aks3g/ai_mini_4wd_kit/src/README.md

# AI ミニ四駆キットSDK
AIミニ四駆キット向けのソフトウェアの開発を行うためのSDKです

## SDK構成
SDKはライブラリ（.aファイルと.hファイル）で提供されます。library/libに.aファイルが、library/includeに.hが入っています。
ライブラリを生成するのに必要なコードはすべて含まれています。

## micro python
本SDKにはmicro pythonのポーティングコードが含まれています。バージョン1.9.4に対するポーティングコードなので、それ以外のバージョンでの動作確認は行っていません。

### 使用方法
メモリカードにBOOT.INIというファイル名の設定ファイルを作成します。
ファイルの中身を次のように記載してください。

```
BOOT.INI
script=<実行したいスクリプトファイル名>
```

このファイルが置かれたメモリカードを挿入して電源をONにすると、指定したスクリプトファイルの実行がスタートします。
