aks3g/ai_mini_4wd_kit/src/release/README.md

ファームウェアのリリース場所です。

### 2019/09/22
初期リリースです。
Bootloaderを新たに用意しました。
microPythonの実効環境を用意しました。
