aks3g/ai_mini_4wd_kit/src/scripts/README.md

# micro Python用サンプルスクリプト集
AIミニ四駆Kit用micro Pythonのサンプルコードです。ほかのPython処理系では動かないのでご注意ください。
また、サンプルコードにBOMがついているとうまく読めない為、BOM無しでメモリカードに保存するようにしてください。

## 注意事項
***古いファームウェアでは、ファイルシステムがロングファイルネームに対応しておりません（いわゆる8文字＋拡張子3文字の名前しか使えない）***
サンプルのご使用に当たってはファイルのリネームをしていただければともいます。
micro Pythonポーティングをビルドして書き込める環境であれば、現在公開されているモノであればログファイルネームが使えます。

***古いファームウェアにはバグが存在し、メモリカード上にtest.pyが存在している必要があります。中身は空でも構いません***

## 使用方法
サンプルスクリプトを使用するための方法を説明します。
### 準備
1. AIミニ四駆Kitとメモリカード（MMC互換カード）を用意します
2. AIミニ四駆Kitにmicro Pythonが動くファームウェアが書き込まれている事を確認します（出荷状態で書き込み済みです）

### 実行手順
1. メモリカードにBOOT.INIというファイルを用意します
BOOT.INIの中に次のような行を記載します。スクリプトファイルの名前は適宜変更してください。
```script = 00x_sample_name_to_execute.py```

2. BOOT.INIで指定したスクリプトをメモリカードに書き込みます
3. メモリカードをAIミニ四駆Kitに差し込みます
4. 電源をONにすると、BOOT.INIにで指定されたスクリプトが実行されます

## サンプル一覧
公開されている（或いは公開予定の）サンプルスクリプトの一覧です

|サンプル名|概要|
|:--------|:---|
|001_sample_LED.py|LEDを点灯させるサンプル|
|002_sample_Switch.py|スイッチ操作を行うサンプル|
|003_sample_move.py|モータードライバを操作するサンプル|
|004_sample_control_velocity.py|PID制御によって、速度を一定に保って走行するサンプル|
|005_sample_internal_trigger.py|内部トリガー（車軸の回転検知）を利用するサンプル|
|006_sample_logging.py|センサのデータを取得しながら走行し、その値をログに残すサンプル|
