aks3g/ai_mini_4wd_kit/doc/notes.pdf

## AI ミニ四駆キット 注意事項

ご使用に当たっての注意事項

AI ミニ四駆キットのソフトウェアは開発が継続中です。ソフトウェアの書き込みには JTAG書き込み機（J-Link や Atmel-Ice など）が別途必要になります。

MMC 互換カードをサポートしていますが、すべてのカードをサポート出来ているわけではありません。場合によっ ては使用できない、あるいはファイルシステムが壊れてファイルが読めなくなるなどの事故が起こる可能性がありま す。内容が消えても問題がない状態のカードをご使用ください。

ハードウェアの不具合について

初期不良については、交換対応をさせていただきます。返金も受け付けますが、バッテリの接続端子は消耗品 であるため、接続端子の家格分を差し引いた金額の返金となる事をご了承ください。 故障時の修理対応も行いますが、製品の性質上（ミニ四駆に載せて走らせてコースアウトすることも多い）、 お受けできない場合もございます。

困ったときは

ハードウェア的な問題か、ソフト的な問題か判別できない場合、Github の Issue にて問題を指摘していただ ければ対応いたします。

Github:https://github.com/aks3g/ai_mini_4wd_kit

問い合わせ先
ハードウェア不具合など、お問い合わせは以下のいずれかにお願いします。 e-mail: Kiyotaka.aks@gmail.com
twitter : https://twitter.com/g_aks

サークル名:あかまる
