aks3g/ai_mini_4wd_kit/doc/figure/connect3.png

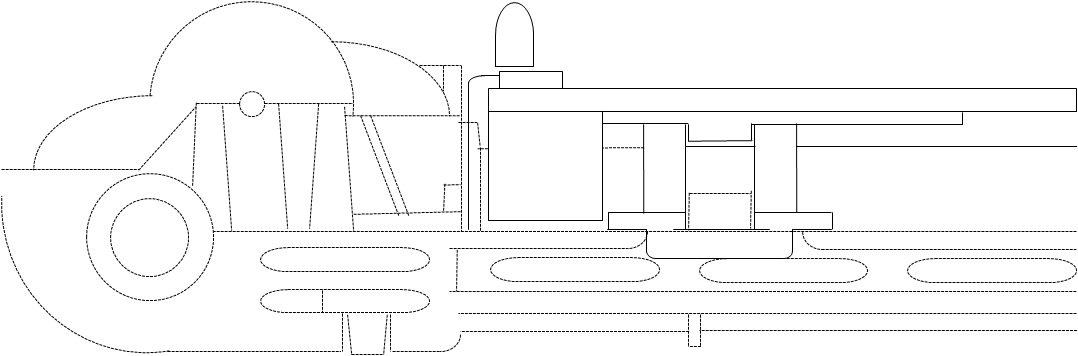
doc/figure/connect3.png
