aks3g/ai_mini_4wd_kit/(threads)

Thread 1 (2019-05-11):

test.pyを配置しないとBOOT.INIが読み込まれない

yukota, 2019-05-11:
test.pyを配置しなかった場合、fatal_errorになり、結果としてBOOT.INIが読み込まれません。
src/script以下にtest.pyを置くか、test.pyがない場合fatalに落ちないようにしたほうがわかりやすいかと思います。

aks3g, 2019-05-13:
期待通りの動きではない（BOOT.INIがtest.pyに依存するのはおかしい）ので修正します。

aks3g, 2019-05-13:
こちら、すいませんコミット前に確認したはずがデバッグ中のコードが残っておりました。
https://github.com/aks3g/ai_mini_4wd_kit/commit/45d6fbbb8115bdc94f4985d53593735f37e6d077

こちらで修正済みです（お恥ずかしい）

yukota, 2019-05-13:
Thank you!

Closed 2019-05-13.

Thread 2 (2019-05-11):

fatal_error時にログが0で埋められる

yukota, 2019-05-11:
__fatal_error時にすべて0で埋められた1MBほどのLOGが出力されれます。
test.pyを配置せず起動した時発生しました。

aks3g, 2019-05-13:
すいません。こちらエラー時の処理の実装がおかしいですね。
1MBの0埋めファイルが出力されるのは期待通りで、一旦フラッシュ上に1MBのファイルを生成しておくことで、フラッシュへの書き込み速度を向上することを狙っています。
通常処理では、スクリプト実行が終わった時点でファイルサイズを切り詰めているのですが、fatal_errorでのハンドリングに失敗しています。こちら修正いたします。

aks3g, 2019-05-13:
こちらの問題、
https://github.com/aks3g/ai_mini_4wd_kit/commit/397fed656ada02aa9ae12c15ee46a473bcba1de8

で修正しました。Fatalに落ちた後に、FatalメッセージをLOGに書き込んだのちにログファイルのサイズを切り詰める処理を入れたので、Fatalのメッセージも読めるようになります。

yukota, 2019-05-13:
ありがとうございます。

Closed 2019-05-13.

Thread 3 (2019-05-13):

Microchip純正のStartup Codeに依存している

aks3g, 2019-05-13:
Startup CodeがMicrochipの提供しているIncludeファイルに一部依存しているのでWindows環境以外でのビルドが面倒になっている。

単に一部のレジスタの定義を使っているだけのようなので自前で書き直して依存を切りたい気持ち。

aks3g, 2019-09-21:
こちら、Packsフォルダに必要なファイルを取り込むという形で対応しました。

Closed 2019-09-21.

Thread 5 (2019-05-31):

MicroPythonからSDカードに対する書き込みができない

yukota, 2019-05-31:
以下のようなコードを実行すると、writeでAttributeError: no such attributeが発生する。
```python
f = open("out.json", 'w')
f.write("aaaa")
f.close()
```

MicroPythonからSDカード上へのファイルへの出入力手段がほしい。

aks3g, 2019-06-06:
すいません。こちらそもそも対応させてませんでした。
ちょっとお時間もらいますが実装します。しばしお待ちを。

aks3g, 2019-06-11:
下回りのライブラリまで変更を入れたので、library/lib/*.a の類の入れ替えも必要になりますが、
micropython側からSDカードアクセスができるようになりました。

お試しいただければと思います。

yukota, 2019-06-13:
動作しました！
ありがとうございます！

一点だけ、Make内のIncludeですが
/packs/arm/CMSIS/Include
を指定していますが、AtmelStudioから持ってきたpacksは以下のようなディレクトリになっています。
/packs/arm/cmsis/5.0.1/CMSIS/Include
以下のようなシンボリックリンクを貼る必要がある旨をどこかに書いておいたほうが良いかと思います。
ln -s cmsis/5.0.1/CMSIS CMSIS

Closed 2019-06-13.

Thread 8 (2019-06-11):

シャーシの色によってはエンコーダがうまく動いてない（ように思う）

aks3g, 2019-06-11:
光学式エンコーダがシャーシの色に影響を受けているように思うので、対応を考える。

現実的にはコンパレータに設定している閾値（DACで生成）を可変にしてあげる事だろうか…。

aks3g, 2019-09-21:
コンパレータに設定している閾値電圧の変更処理、
閾値電圧のNVMへの保存
セルフキャリブレーション機能の実装を行ったので閉じます。

Closed 2019-09-21.
