aks3g/ai_mini_4wd_kit/elec/schematics_v4.pdf

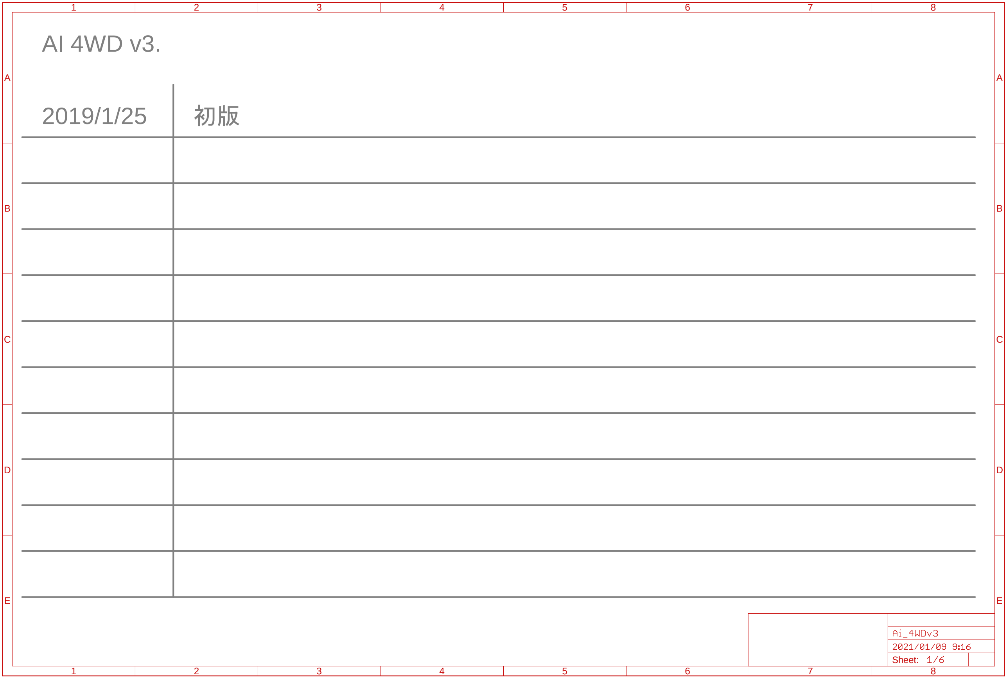
[picture p8: figure]
Sheet:

2021/01/09 9:17 C:\cygwin64\home\kiyot\src\ai_mini_4wd\trunk\elec\circuit\AI_4WDv4\AI_unit\Ai_4WDv3.sch (Sheet: 1/6)

A

A

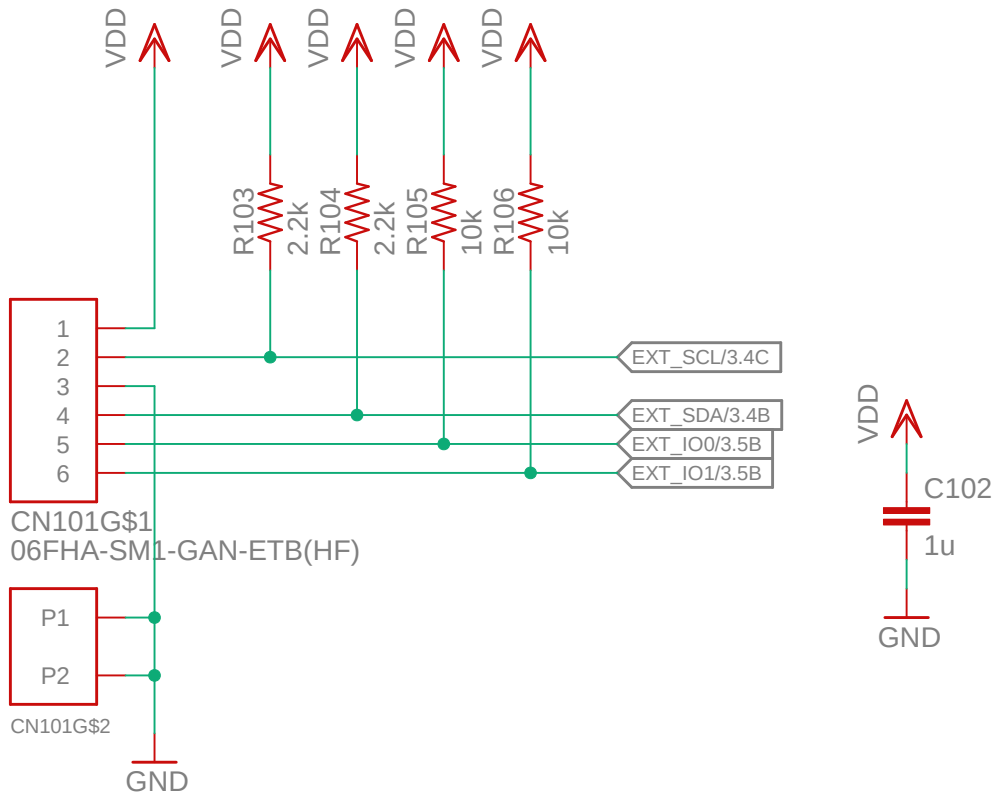
[picture p9: page 2]
GND VDD; 1u VDD; GND ².2k; 10k VDD; VDD; R¹⁰³; R¹⁰⁴; R¹⁰⁵; R¹⁰⁶; EXT_SCL/3.4C; EXT_SDA/3.4B EXT_IO0/3.5B EXT_IO1/3.5B; Sheet:; Ai_4WDv3

06FHA-SM1-GAN-ETB(HF)

2021/01/09 9:17 C:\cygwin64\home\kiyot\src\ai_mini_4wd\trunk\elec\circuit\AI_4WDv4\AI_unit\Ai_4WDv3.sch (Sheet: 2/6)

# GND¹k VDD

GND | GND | 100k | 100k | 100k | 100k | 10k VDD | VDD | VDD | VDD | VDD VDD

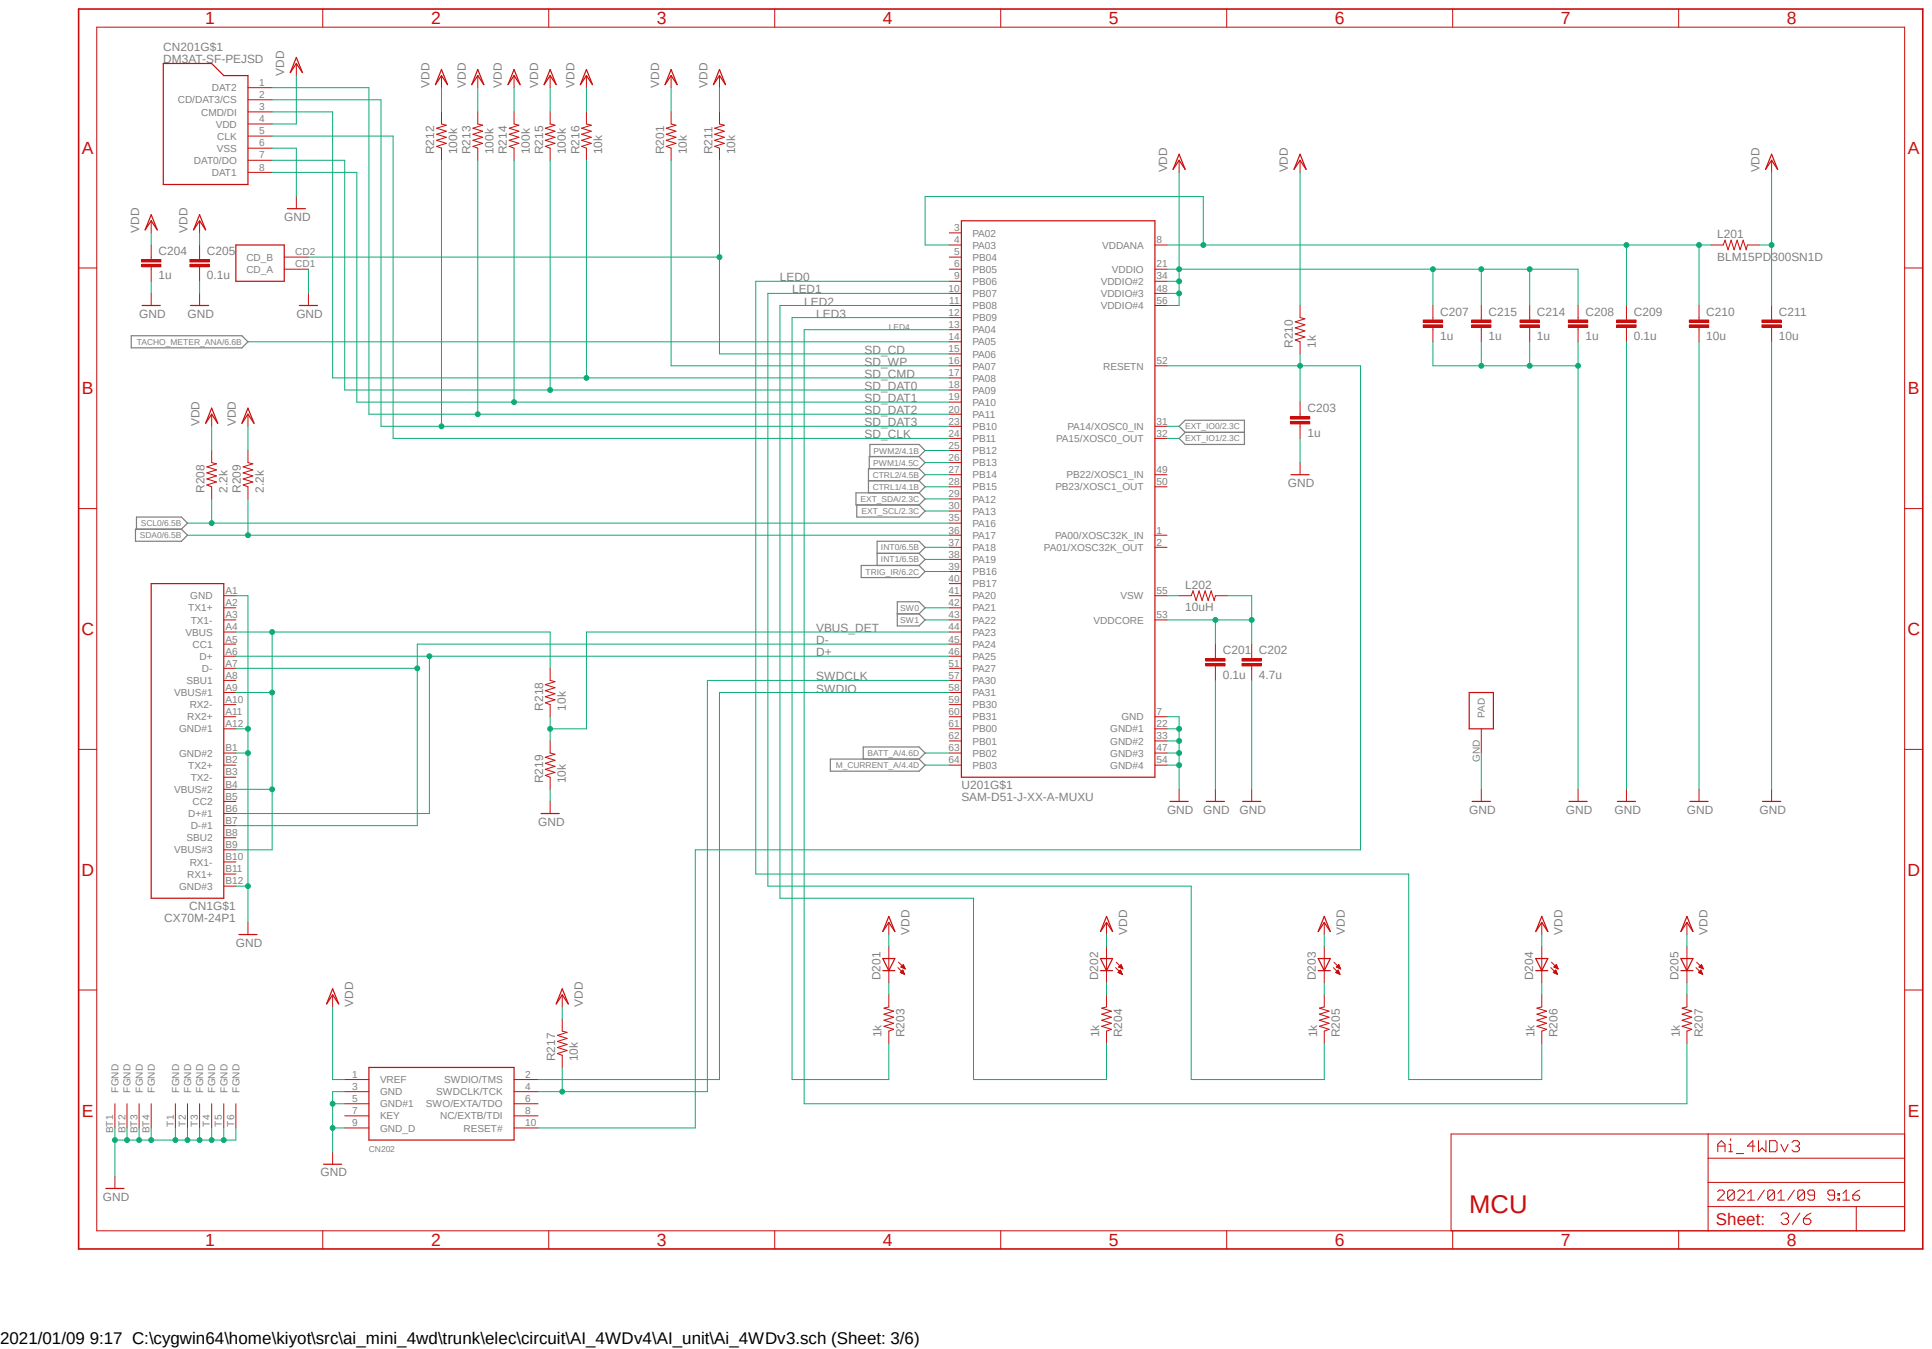
[picture p10: page 3]

SD_CMD | GND VDD L202

LED4 SD_DAT2 SD_CD

SD_WP
SD_DAT0
SD_DAT1
SD_DAT3
SD_CLK

VBUS_DET
D-
D+
SWDCLK
SWDIO

MCU

Sheet:

2021/01/09 9:17 C:\cygwin64\home\kiyot\src\ai_mini_4wd\trunk\elec\circuit\AI_4WDv4\AI_unit\Ai_4WDv3.sch (Sheet: 3/6)

# GND VCC

IN | 3 OUT 4 | GND 2 | U6 VDD | 1

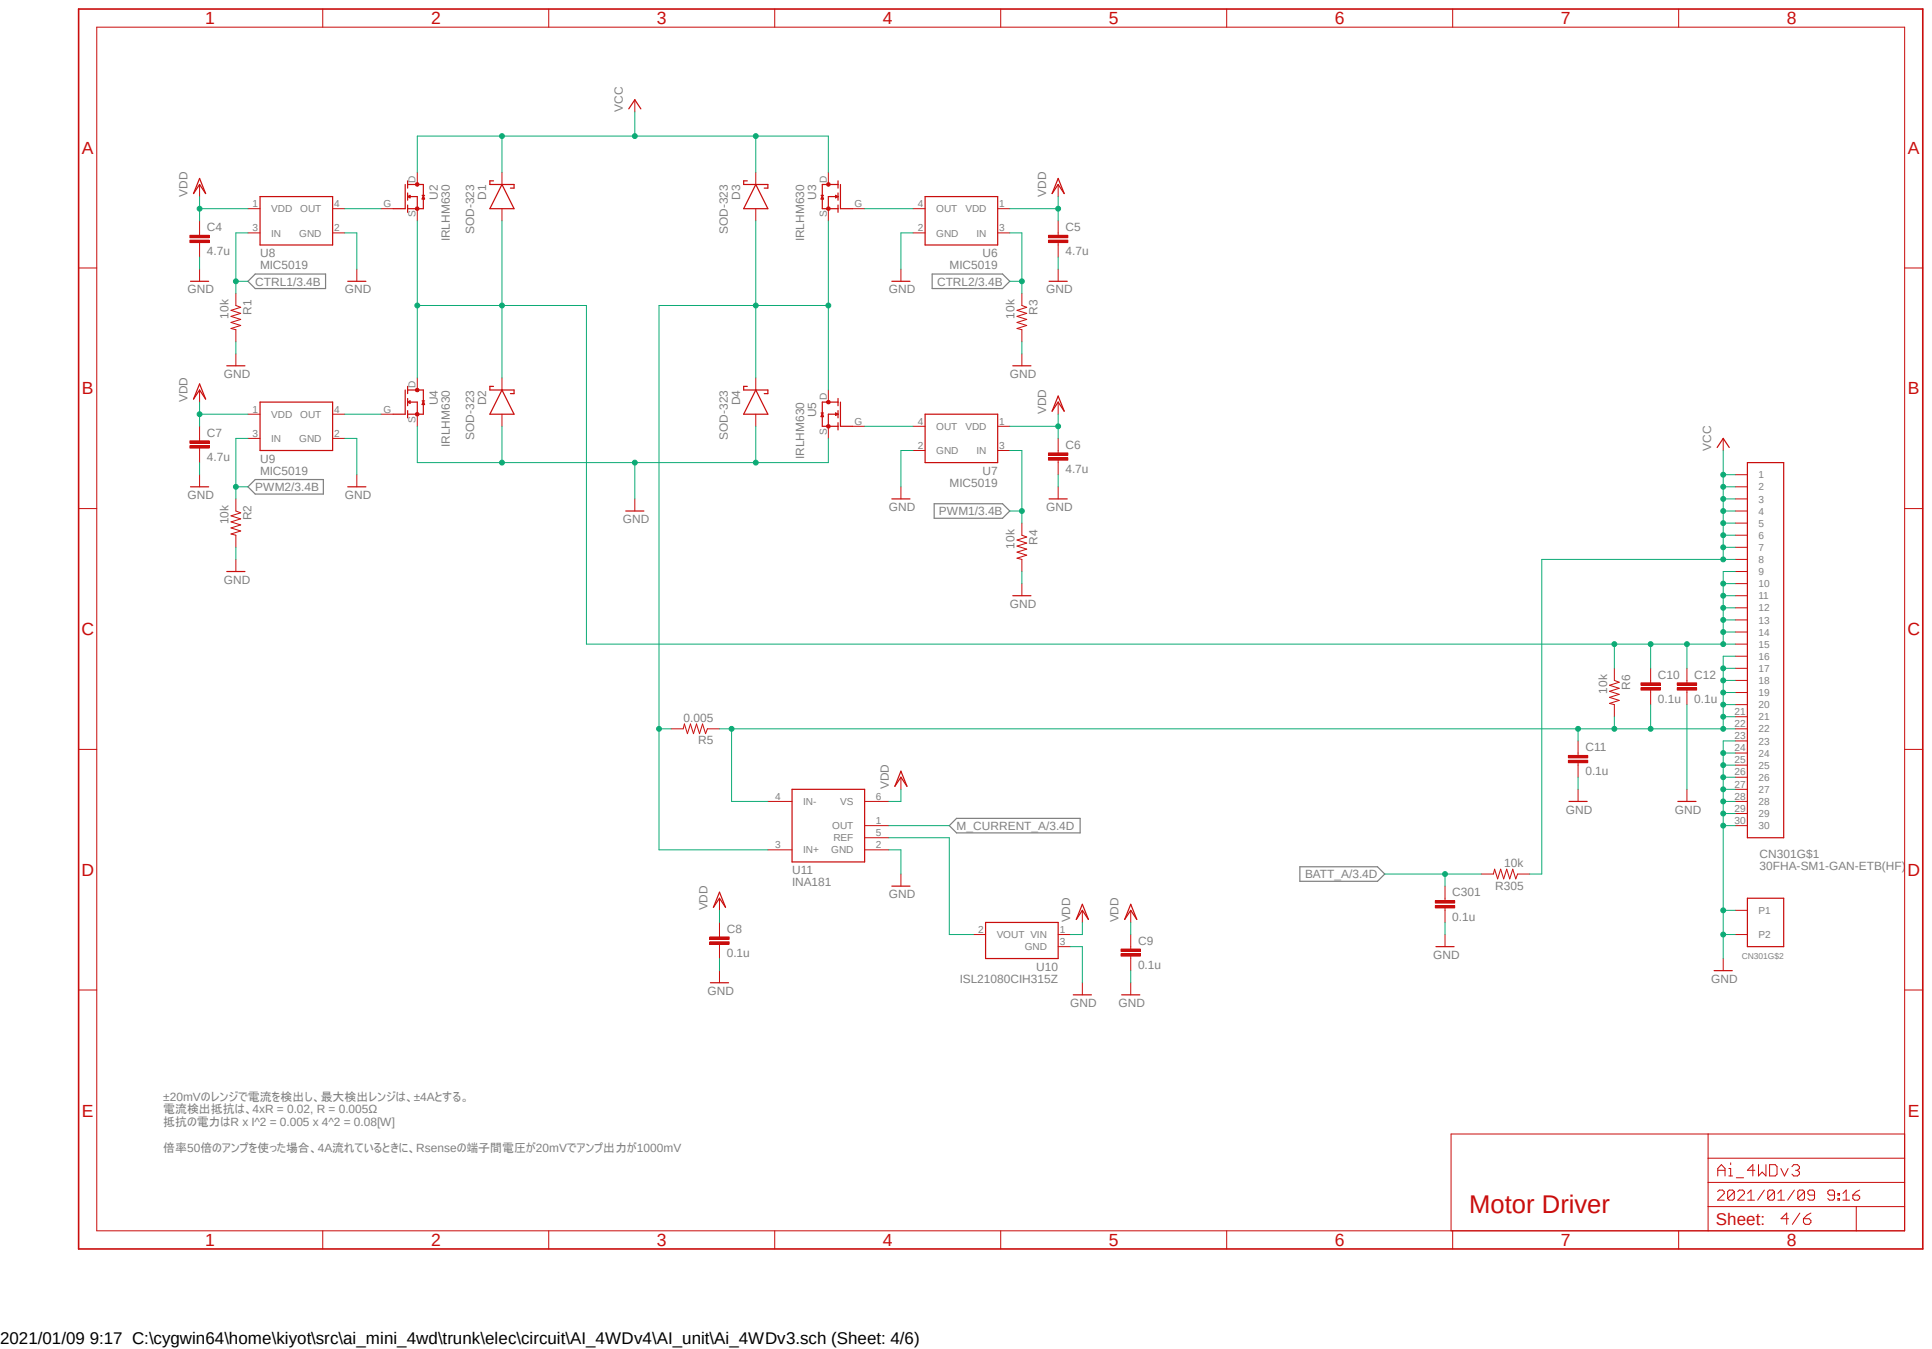
[picture p11: page 4]

2021/01/09 9:17 C:\cygwin64\home\kiyot\src\ai_mini_4wd\trunk\elec\circuit\AI_4WDv4\AI_unit\Ai_4WDv3.sch (Sheet: 4/6)

A

A

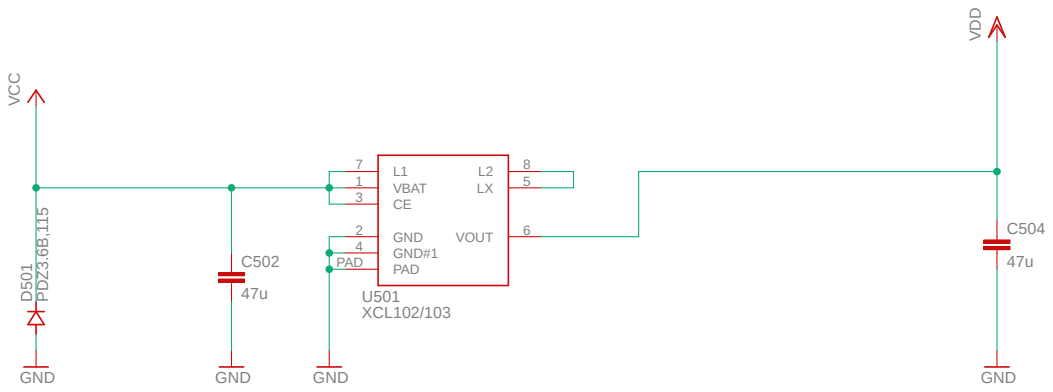
[picture p12: page 5]
GND VCC; VDD; GND; XCL102/103; GND D⁵⁰¹; GND 2; PAD PAD; VOUT; 8 VBAT 1; GND#1 4U501

2021/01/09 9:17 C:\cygwin64\home\kiyot\src\ai_mini_4wd\trunk\elec\circuit\AI_4WDv4\AI_unit\Ai_4WDv3.sch (Sheet: 5/6) PDZ3.6B,115

Power

Sheet:

# GND VDD 51k VDD

A

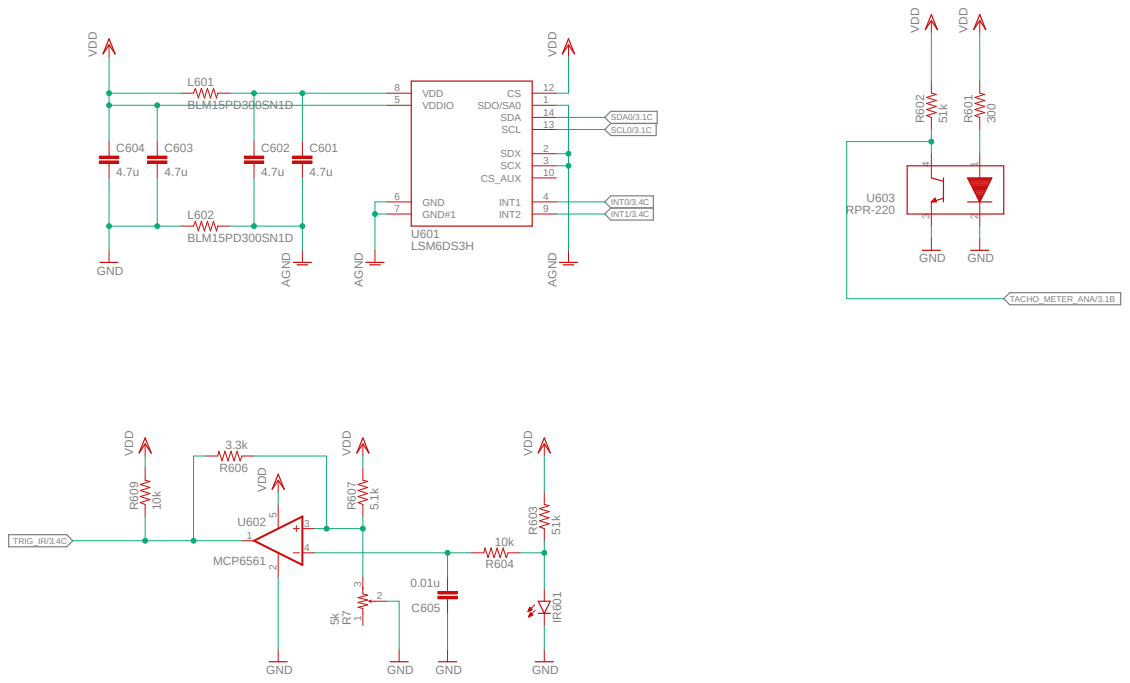
[picture p13: page 6]

Sensor

Sheet:

2021/01/09 9:17 C:\cygwin64\home\kiyot\src\ai_mini_4wd\trunk\elec\circuit\AI_4WDv4\AI_unit\Ai_4WDv3.sch (Sheet: 6/6)
