aks3g/ai_mini_4wd_kit/elec/schematics.pdf

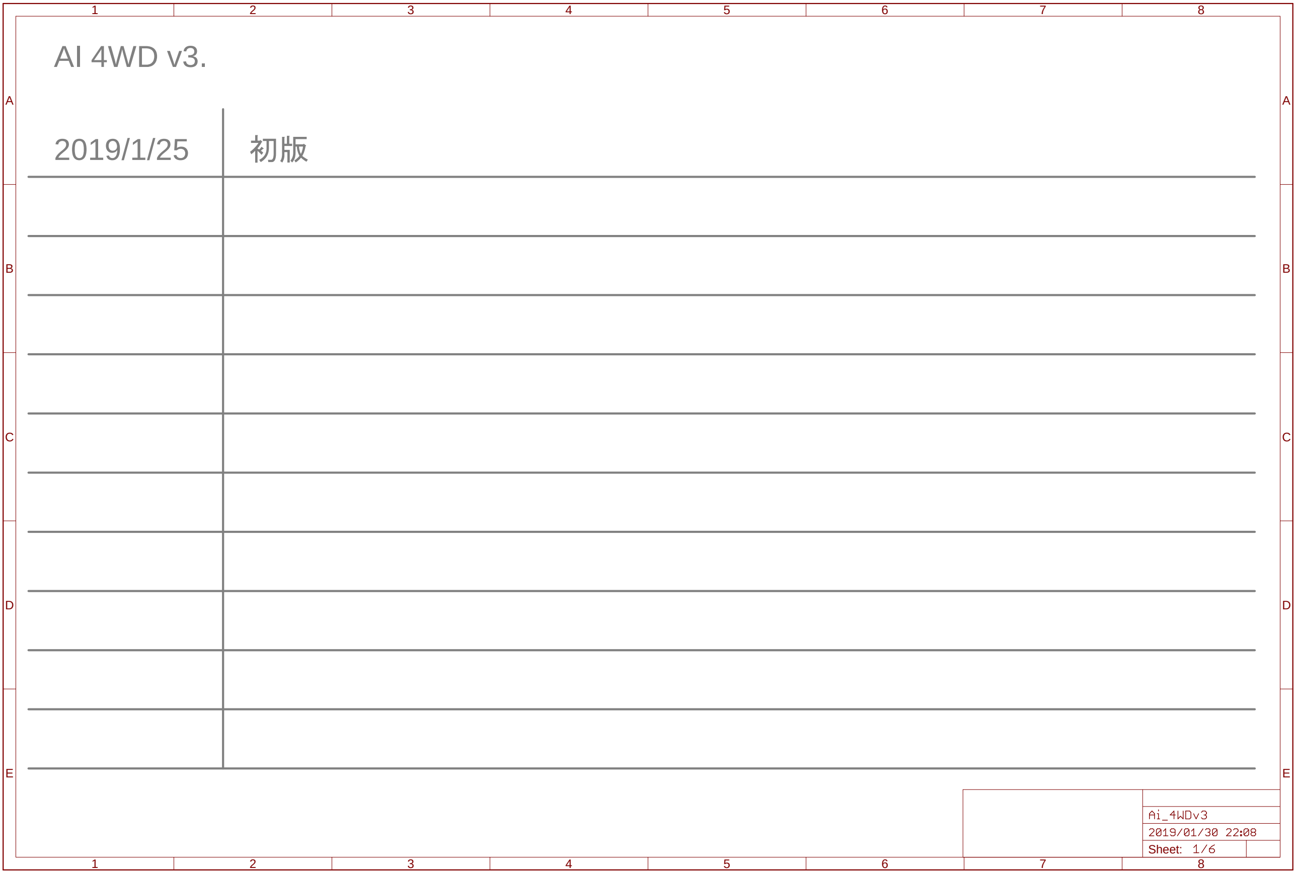
[picture p14: figure]
Sheet:

A

A

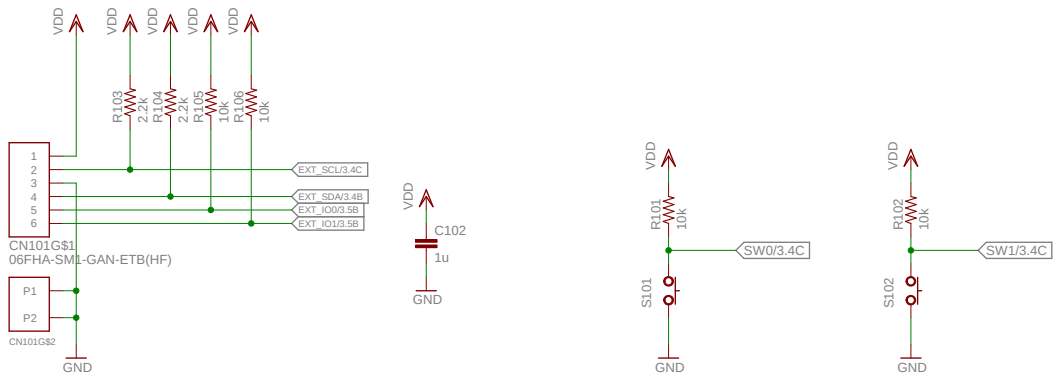
[picture p15: page 2]
GND VDD; 1u VDD; GND; 10k VDD; GND ².2k; VDD; S¹⁰¹ R¹⁰¹; S¹⁰² R¹⁰² R¹⁰³; R¹⁰⁴; R¹⁰⁵; R¹⁰⁶; EXT_SCL/3.4C; EXT_SDA/3.4B EXT_IO0/3.5B EXT_IO1/3.5B; Ai_4WDv3

06FHA-SM1-GAN-ETB(HF)

# GND¹k VDD

GND | GND | 100k | 100k | 100k | 100k | 10k VDD | VDD | VDD | VDD | VDD VDD

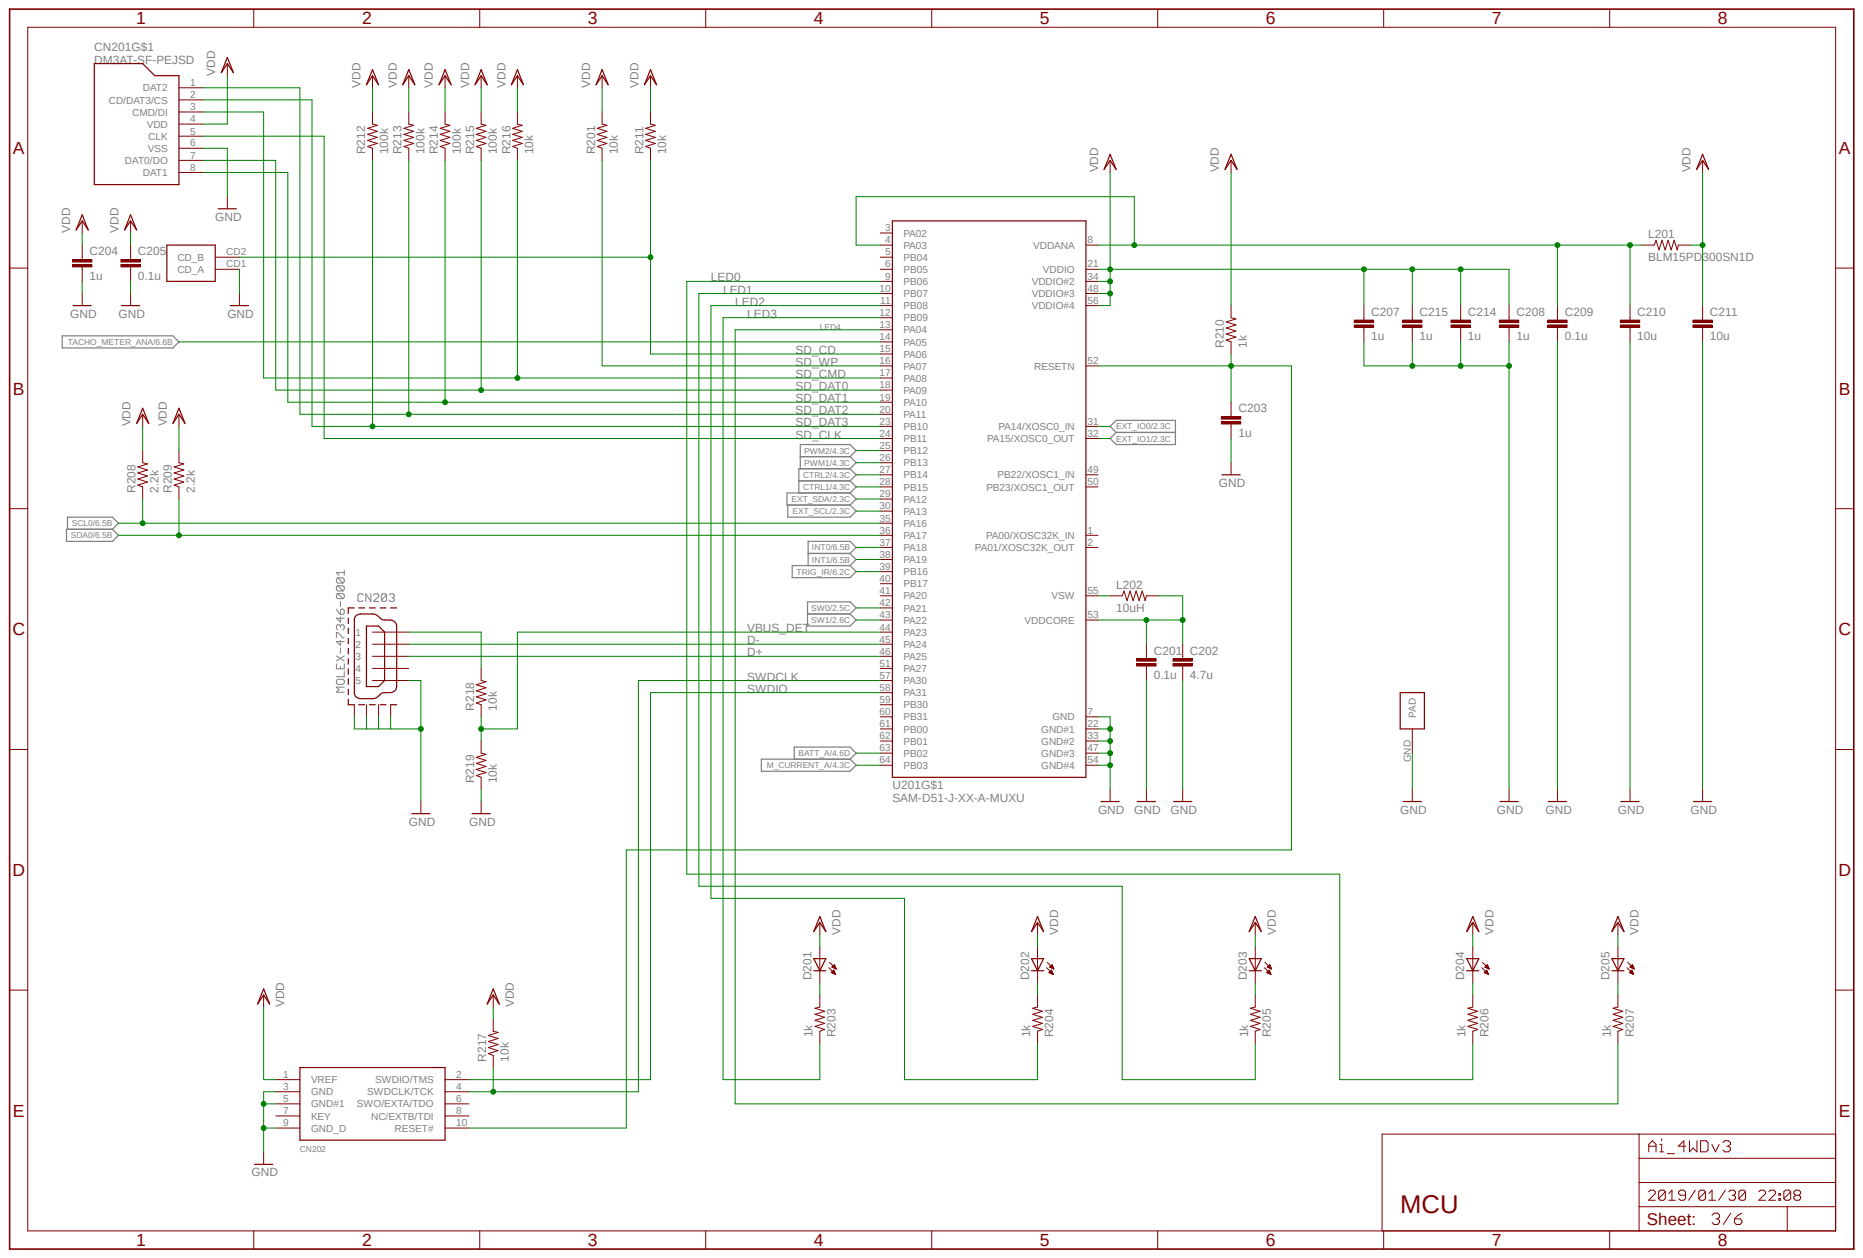
[picture p16: page 3]

SD_CMD | GND VDD L202

LED4 SD_DAT2 SD_CD

SD_WP
SD_DAT0
SD_DAT1
SD_DAT3
SD_CLK

VBUS_DET
D-
D+
SWDCLK
SWDIO

A

A

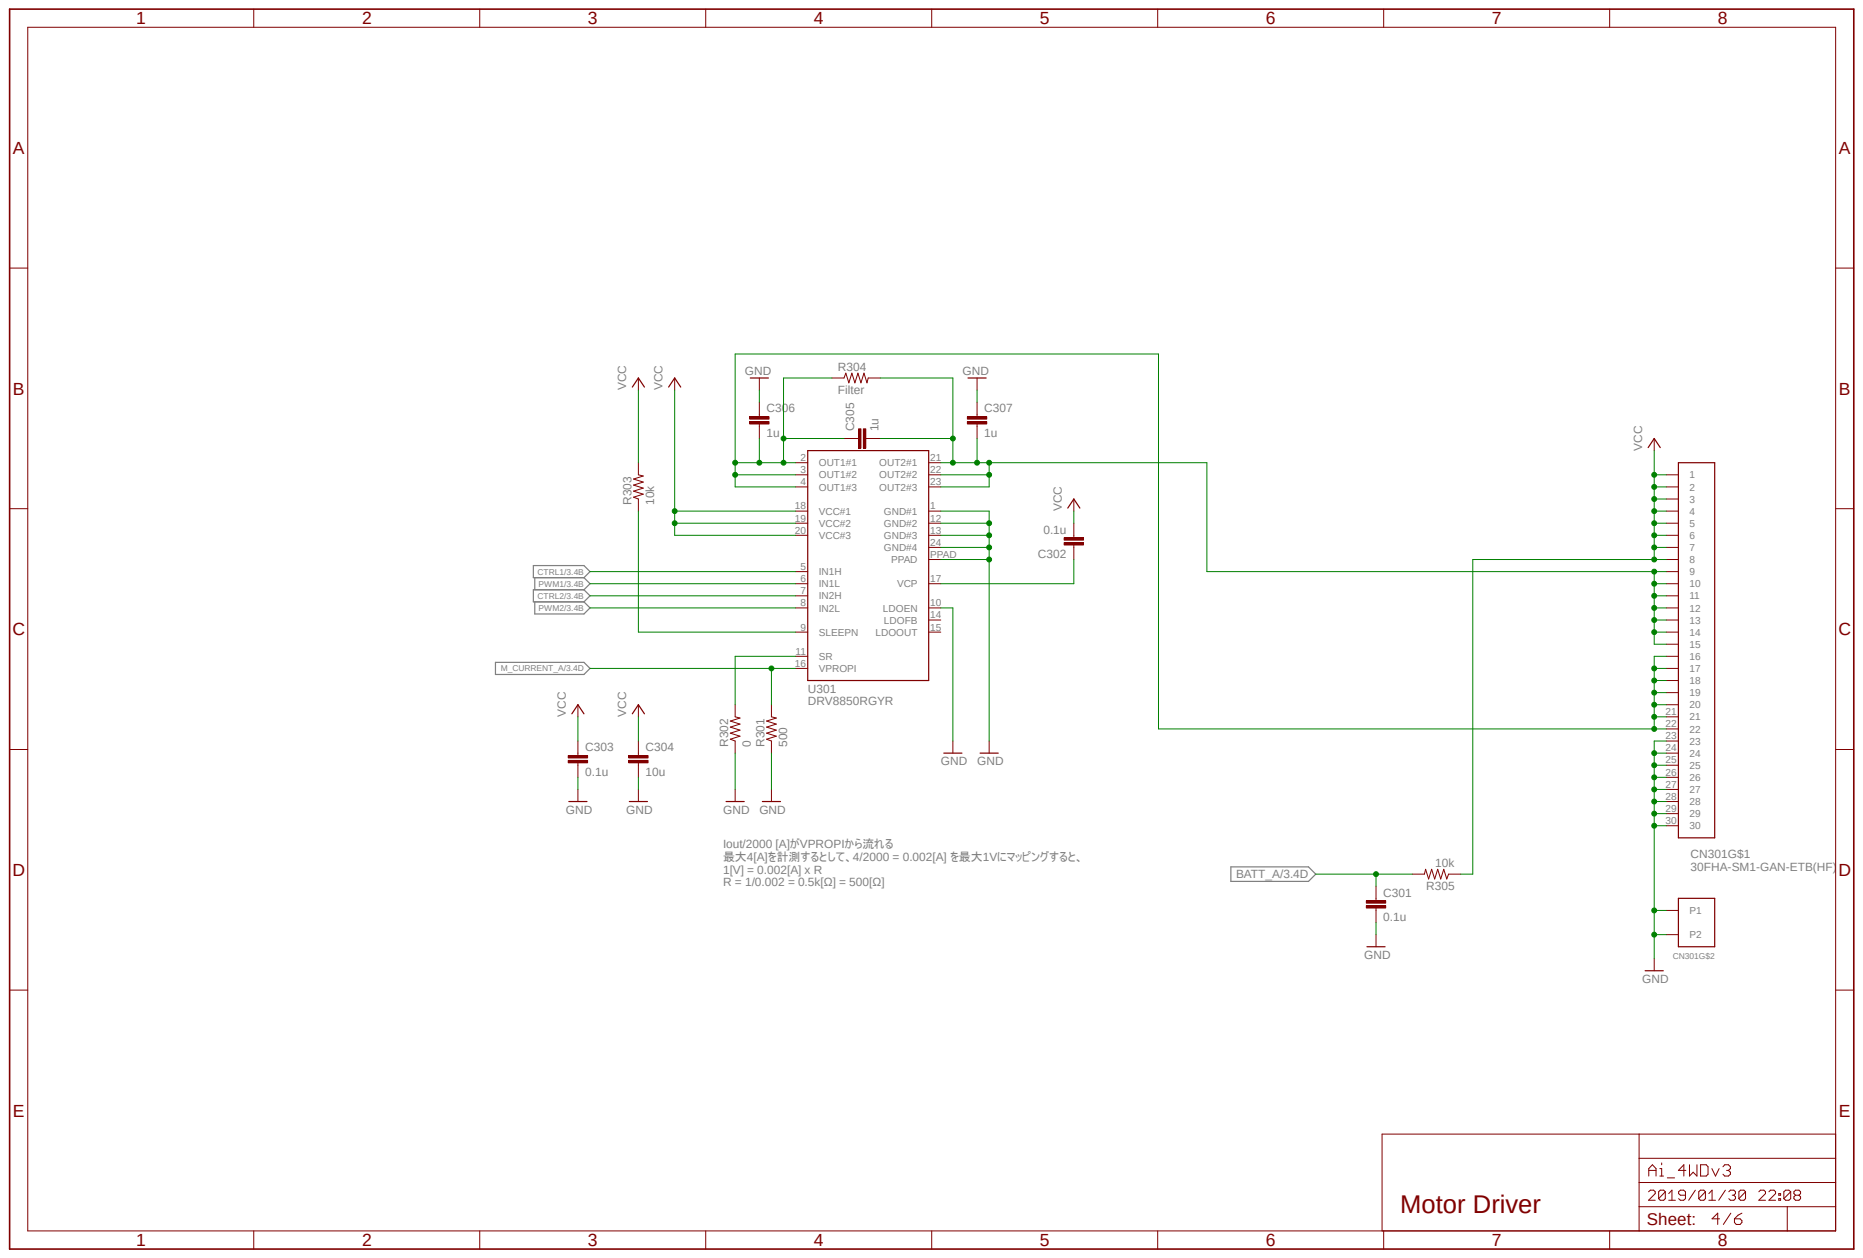
[picture p17: page 4]

A

A

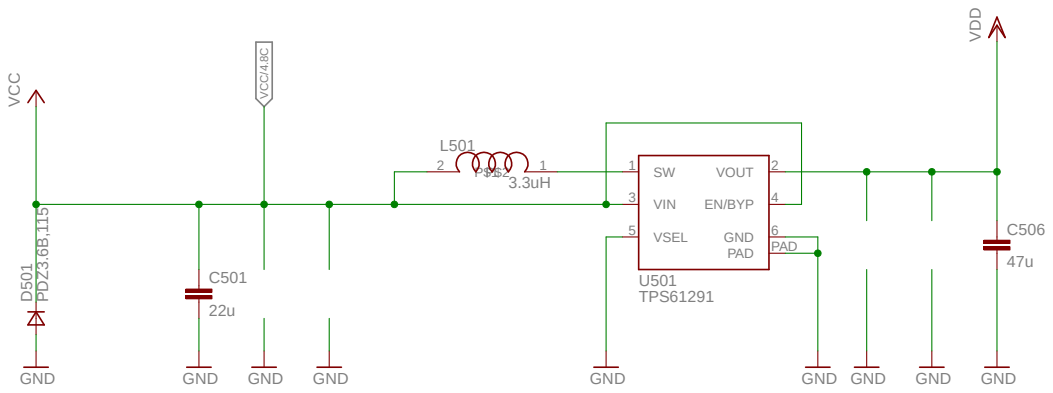
[picture p18: page 5]
PDZ3.6B,115; GND; GND GND; GND VCC; VDD; TPS61291; GND D⁵⁰¹; VOUT; 2 VIN 3; 6 VSEL 5; EN/BYP; 4 PAD; PAD; L501 VCC/4.8C; Power

# GND VDD 51k VDD

A

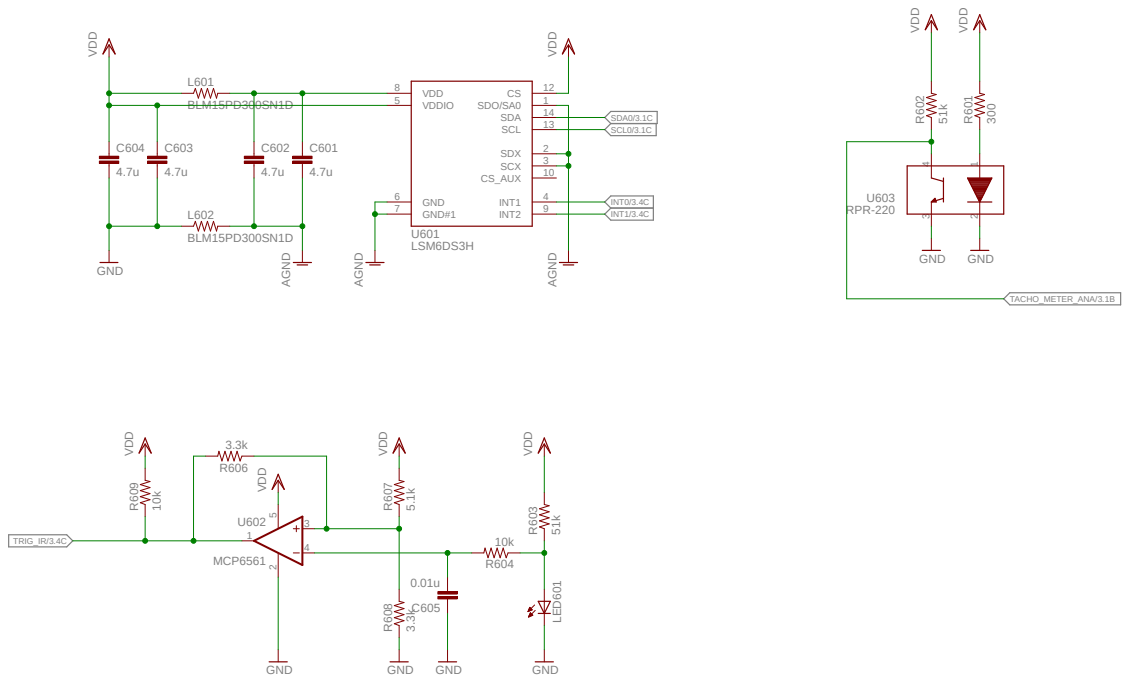
[picture p19: page 6]
