aks3g/ai_mini_4wd_kit/src/micro_python/ports/ai_mini4wd/mpconfigport.h

/*
 * mphalport.h
 *
 * Created: 2019/03/10
 * Copyright 2019 Kiyotaka Akasaka. All rights reserved.
 */ 

#ifndef MPCONFIGPORT_H_
#define MPCONFIGPORT_H_


#include <stdint.h>

// options to control how MicroPython is built

// You can disable the built-in MicroPython compiler by setting the following
// config option to 0.  If you do this then you won't get a REPL prompt, but you
// will still be able to execute pre-compiled scripts, compiled with mpy-cross.
#define MICROPY_OBJ_REPR (MICROPY_OBJ_REPR_C)

#define MICROPY_ENABLE_COMPILER					(1)

#define MICROPY_QSTR_BYTES_IN_HASH				(1)
#define MICROPY_QSTR_EXTRA_POOL					mp_qstr_frozen_const_pool
#define MICROPY_ALLOC_PATH_MAX					(256)
#define MICROPY_ALLOC_PARSE_CHUNK_INIT			(16)
#define MICROPY_EMIT_X64						(0)
#define MICROPY_EMIT_THUMB						(0)
#define MICROPY_EMIT_INLINE_THUMB				(0)
#define MICROPY_COMP_MODULE_CONST				(1)
#define MICROPY_COMP_CONST						(0)
#define MICROPY_COMP_DOUBLE_TUPLE_ASSIGN		(0)
#define MICROPY_COMP_TRIPLE_TUPLE_ASSIGN		(0)
#define MICROPY_MEM_STATS						(0)
#define MICROPY_DEBUG_PRINTERS					(0)
#define MICROPY_ENABLE_GC						(1)
#define MICROPY_GC_ALLOC_THRESHOLD				(0)
#define MICROPY_REPL_EVENT_DRIVEN				(0)
#define MICROPY_HELPER_REPL						(1)
#define MICROPY_HELPER_LEXER_UNIX				(0)
#define MICROPY_ENABLE_SOURCE_LINE				(1)
#define MICROPY_ENABLE_DOC_STRING				(1)
#define MICROPY_ERROR_REPORTING					(MICROPY_ERROR_REPORTING_TERSE)
#define MICROPY_BUILTIN_METHOD_CHECK_SELF_ARG	(0)
#define MICROPY_PY_ASYNC_AWAIT					(0)
#define MICROPY_PY_BUILTINS_BYTEARRAY			(1)
#define MICROPY_PY_BUILTINS_MEMORYVIEW			(0)
#define MICROPY_PY_BUILTINS_ENUMERATE			(0)
#define MICROPY_PY_BUILTINS_FILTER				(0)
#define MICROPY_PY_BUILTINS_FROZENSET			(0)
#define MICROPY_PY_BUILTINS_REVERSED			(0)
#define MICROPY_PY_BUILTINS_SET					(0)
#define MICROPY_PY_BUILTINS_SLICE				(0)
#define MICROPY_PY_BUILTINS_PROPERTY			(1)
#define MICROPY_PY_BUILTINS_MIN_MAX				(0)
#define MICROPY_PY___FILE__						(0)
#define MICROPY_PY_GC							(1)
#define MICROPY_PY_ARRAY						(1)
#define MICROPY_PY_ATTRTUPLE					(1)
#define MICROPY_PY_COLLECTIONS					(0)
#define MICROPY_PY_BUILTINS_COMPLEX				(1)
#define MICROPY_PY_MATH_SPECIAL_FUNCTIONS		(1)
#define MICROPY_PY_MATH							(1)
#define MICROPY_PY_CMATH						(1)
#define MICROPY_PY_IO							(1)
#define MICROPY_PY_STRUCT						(1)
#define MICROPY_PY_SYS							(0)

#define MICROPY_READER_VFS						(1)
#define MICROPY_VFS								(1)
#define MICROPY_VFS_FAT							(0)
#define MICROPY_PY_IO_FILEIO					(0)

#define MICROPY_MODULE_BUILTIN_INIT				(1)
#define MICROPY_MODULE_WEAK_LINKS				(1)
#define MICROPY_MODULE_FROZEN_STR				(0)
#define MICROPY_MODULE_FROZEN_MPY				(1)

#define MICROPY_CPYTHON_COMPAT					(0)
#define MICROPY_LONGINT_IMPL					(MICROPY_LONGINT_IMPL_NONE)
#define MICROPY_FLOAT_IMPL						(MICROPY_FLOAT_IMPL_FLOAT)

// extended modules
#define MICROPY_PY_UJSON						(1)
#define MICROPY_PY_URANDOM						(1)
#define MICROPY_PY_URANDOM_EXTRA_FUNCS			(1)


// fatfs configuration used in ffconf.h
#define MICROPY_FATFS_ENABLE_LFN				(1)
#define MICROPY_FATFS_LFN_CODE_PAGE				(437) /* 1=SFN/ANSI 437=LFN/U.S.(OEM) */
#define MICROPY_FATFS_USE_LABEL					(1)
#define MICROPY_FATFS_RPATH						(2)
#define MICROPY_FATFS_MULTI_PARTITION			(1)

//#define mp_type_fileio fatfs_type_fileio
//#define mp_type_textio fatfs_type_textio

// type definitions for the specific machine

#define MICROPY_MAKE_POINTER_CALLABLE(p) ((void*)((mp_uint_t)(p) | 1))

// This port is intended to be 32-bit, but unfortunately, int32_t for
// different targets may be defined in different ways - either as int
// or as long. This requires different printf formatting specifiers
// to print such value. So, we avoid int32_t and use int directly.
#define UINT_FMT "%u"
#define INT_FMT "%d"
typedef int mp_int_t; // must be pointer size
typedef unsigned mp_uint_t; // must be pointer size

typedef long mp_off_t;

#define MP_PLAT_PRINT_STRN(str, len) mp_hal_stdout_tx_strn_cooked(str, len)


#define mp_import_stat mp_vfs_import_stat
#define mp_builtin_open mp_vfs_open
#define mp_builtin_open_obj mp_vfs_open_obj

// extra built in names to add to the global namespace
#define MICROPY_PORT_BUILTINS \
{ MP_ROM_QSTR(MP_QSTR_open), MP_ROM_PTR(&mp_builtin_open_obj) },

// We need to provide a declaration/definition of alloca()
#include <alloca.h>

#define MICROPY_HW_BOARD_NAME "mini4wdKit"
#define MICROPY_HW_MCU_NAME "SAMD51"

#ifdef __linux__
#define MICROPY_MIN_USE_STDOUT (1)
#endif

#ifdef __thumb__
#define MICROPY_MIN_USE_CORTEX_CPU (1)
#define MICROPY_MIN_USE_STM32_MCU (1)
#endif

#define MP_STATE_PORT MP_STATE_VM

#define MICROPY_PORT_ROOT_POINTERS \
const char *readline_hist[8];


// extra builtin modules to add to the list of known ones
extern const struct _mp_obj_module_t pyb_module;
extern const struct _mp_obj_module_t mini4wd_module;


//J モジュール追加
#define MICROPY_PORT_BUILTIN_MODULES \
    { MP_ROM_QSTR(MP_QSTR_pyb), MP_ROM_PTR(&pyb_module) }, \
    { MP_ROM_QSTR(MP_QSTR_mini4wd), MP_ROM_PTR(&mini4wd_module) }, \


#endif /* MPCONFIGPORT_H_ */
