aks3g/ai_mini_4wd_kit/src/micro_python/ports/ai_mini4wd/qstrdefsport.h

/*
 * qstrdefsport.h
 *
 * Created: 2019/03/10
 * Copyright 2019 Kiyotaka Akasaka. All rights reserved.
 */
#ifndef QSTRDEFSPORT_H_
#define QSTRDEFSPORT_H_


//J Mini4wd
Q(mini4wd)
Q(Machine)

Q(led)
Q(ext_led)
Q(sw)

Q(setDuty)
Q(getDuty)
Q(setRpm)
Q(setSpeed)
Q(setMinusCountMax)
Q(setTireSize)
Q(setGainKp)
Q(setGainKi)
Q(setGainKd)
Q(grab)
Q(getCount)
Q(getAx)
Q(getAy)
Q(getAz)
Q(getRoll)
Q(getPitch)
Q(getYaw)
Q(getSpeed)
Q(getRpm)
Q(getVbat)
Q(getMotorCurrent)
Q(waitIntTrig)
Q(waitExtTrig)
Q(checkExtTrig)
Q(setGain)

Q(calibrateTachometer)
Q(setTachometerThreshold)

//J Estimater
Q(Localization)
Q(push_map_item)
Q(len)
Q(prepare)
Q(estimate)
Q(set_weight)
Q(get_probability)

// Machine Learning
Q(MachineLearning)
Q(set_reward)
Q(get_policy)
Q(set_policy)
Q(update)


//J FS
Q(ai_mini4wd_disk)
Q(readblocks)
Q(writeblocks)
Q(ioctl)

Q(extOut)

//J PYB
Q(pyb)
Q(millis)
Q(elapsed_millis)
Q(delay)

Q(real)
Q(imag)
Q(complex)
Q(float)
Q(math)
Q(cmath)
Q(e)
Q(erf)
Q(degrees)
Q(radians)
Q(trunc)
Q(gamma)

// ext
Q(urandom)


Q(VfsAiMini4wd)
Q(readlines)
Q(tell)
Q(__del__)
Q(TextIOWrapper)


#endif /* QSTRDEFSPORT_H_ */
