aks3g/ai_mini_4wd_kit/(commit log)

2019-04-13 Add sample scripts
2019-05-09 Add Sample Project
2019-05-13 Improve the termination of logfile on fatal error.
    [main.c]
2019-06-12 Add NVMCtrl driver. - write/read/erase is supported.
2019-07-22 Add estimater for velocity and odometry
2019-08-26 add interface to read current duty cycle
2019-09-04 Add new if for Pwm Controler to get current duty.
2019-09-16 Support self calibration of tachometer.
2019-09-21 Add new samples. Add process to calibrate tachometer in diag.py
2019-11-21 Support workaround for test hw
    [main.c]
2020-02-18 Support Registory. Add driver for usb device.
2020-02-20 Support software LPF for motor current.
2020-09-11 For FSS2020. Support USB device.
2021-03-01 Support I2C Slave Interface. Support reading raw count from mouse module.
2021-03-01 Support I2c on External Interface. \nSupport Odometer unit.
2021-03-03 Workaround for stucking i2c driver for external I/F\nFix the aligns on USB modules.
    [adns9800.c, main.c, odometer_reg.c, odometer_reg.h]
2021-06-11 add an option unit. LED indicator.
2021-06-11 Add gain table for variable velocity Support LED indicator
2021-06-11 Support interface to change green leds
2021-06-11 Support LED indicator.
2021-07-24 Add SPI driver. Update Timer driver, libconsole
2021-07-24 Initial Code for chassis dynamo for mini4wd
2021-08-06 Reset to bootloader on VBUS ON.
    [main.c]
2021-08-06 Support monitring Battery Voltage
2021-11-15 Change way to mesure velocity.
2021-12-10 Set collect PID/VID
2022-09-05 Improve Trackability of PID controller. Add interface to update PID gain.
2022-09-05 Add new tool to view sensor data.
2022-12-11 Fix the bug. The input of PID control is wrong if sensors detect invalid frequency from encoder.
    [machine_learning_type.c]
2023-02-15 add new tool to visualize sensor data."
2023-03-19 Support QSPI Disk driver. Add driver for MX25x
2023-03-19 Support SPI flash disk. 2 phase encoder
2023-03-19 Add IAM-20680 driver
2023-05-13 Support RTC Support FileSystem with SPI Flash memory Support RTOS. New build configuration and macro switches.
2023-05-13 Support SAMD51 for TOPPERS/ASP
    [chip_timer.cfg]
2023-05-31 Support AImini4wd
    [ai_mini4wd_os.cfg]
